Dieu-de-l-elec/IOX-77-Devboard/CAD-and-Renders/IOX_77_RENDER_01_CG_9.png

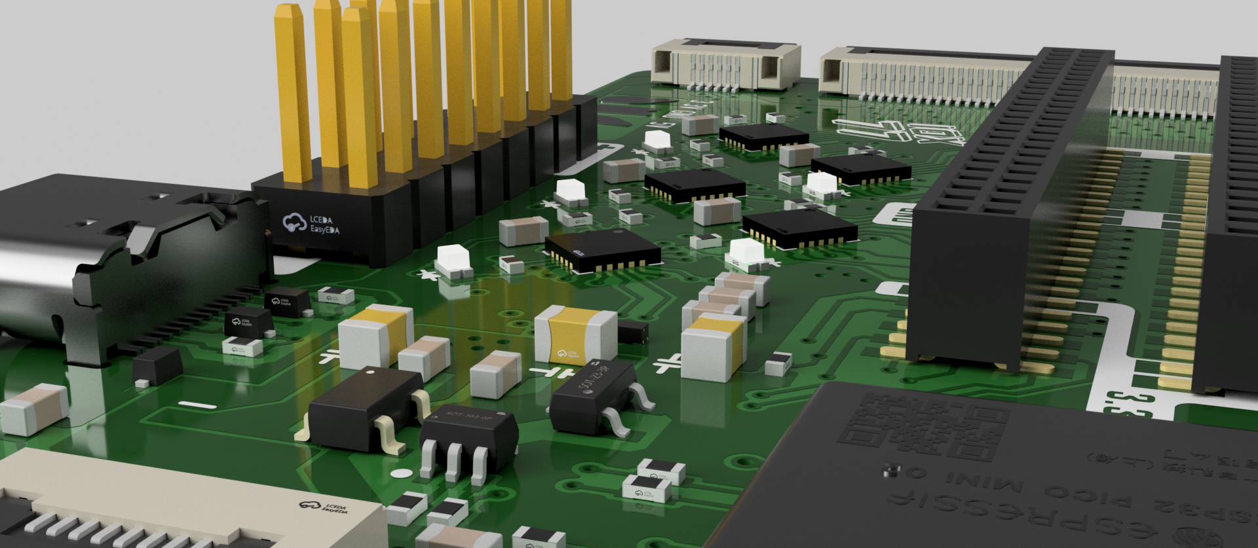
CAD-and-Renders/IOX_77_RENDER_01_CG_9.png
