Dieu-de-l-elec/IOX-77-Devboard/PINOUT/IOX_77_pinout.pdf

3.3V 3.3V 3.3V 3.3V 3.3V GND GND GND GND GND GND B.PD0 B.PC6 B.PC5 C.PC6 C.PC5 A.PC6 A.PC5 E.PC6 E.PC5 D.PC6 D.PC5 +5V +5V 3.3V 3.3V GND GND 3.3V A.PC7 A.PD0 C.PC7 3.3V D.PC7 E.PD0 C.PD0 SDA SCL TXRX B.PC7 E.PC7 ENBOOT GND

## 5V tolerant pins

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
9 | C.PC3
10 | B.PC4
11 | B.PC7
12 | B.PD2
13 | B.PD3
14 | B.PD4
15 | B.PD5
16 | B.PD6
17 | C.PA2
18 | C.PA1
19 | +3.3V
20 | +3.3V
21 | +3.3V
22 | +3.3V
23 | C.PC6
24 | C.PC5
25 | A.PD2
26 | A.PD3
27 | A.PD4
28 | A.PD5
29 | A.PD6
30 | A.PC7
31 | A.PC6
32 | A.PC5
33 | A.PC4
34 | A.PC3
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
# GND

TX
RX

# SCL SDA

+3.3V

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
# GND

# C.SWIO B.SWIO A.SWIO E.SWIO D.SWIO

+3.3V

IOX-77 PINOUT ⁵V T. 5V T.

10.04.2026

C. G.
#Dieu de l’élec | BOOT

# RST

# PRG

# IOs

# COM

# IOs

# COM

# PRG FPCs

Headers 2x25 1.27mm | 3.3V B.PA2 | A.PD5 A.PD6 | A.PA2 | C.PA2 | C.PD5 D.PD5 | D.PD6 | C.PD6 | E.PA2 B.PD6 | B.PD5 | E.PD6 | E.PD5 C.PC3 | B.PC0 | A.PC0 | A.PC3 | D.PD0 | D.PC0 | D.PC3 B.PA1 | A.PD4 | A.PD2 A.PD3 | A.PA1 | C.PD2 | E.PA1 | D.PC4 E.PC0 B.PC3 | E.PC3 D.PD2 | D.PD3 | D.PD4 | C.PA1 | C.PD3 | C.PC4 | D.PA1 B.PD4 | B.PD3 | B.PD2 | B.PC4 | E.PD4 | E.PD3 | E.PD2 | E.PC4 A.PC4 | C.PC0 | D.PA2 C.PD4

# GND GND B.PC5 P.PC6 B.PA1 B.PA2 B.PD0 B.PC0

# A.PC0 A.PD0 A.PA2 A.PA1 GND GND

PWM | ANALOG | IO.3 | IO.2 | IO.0

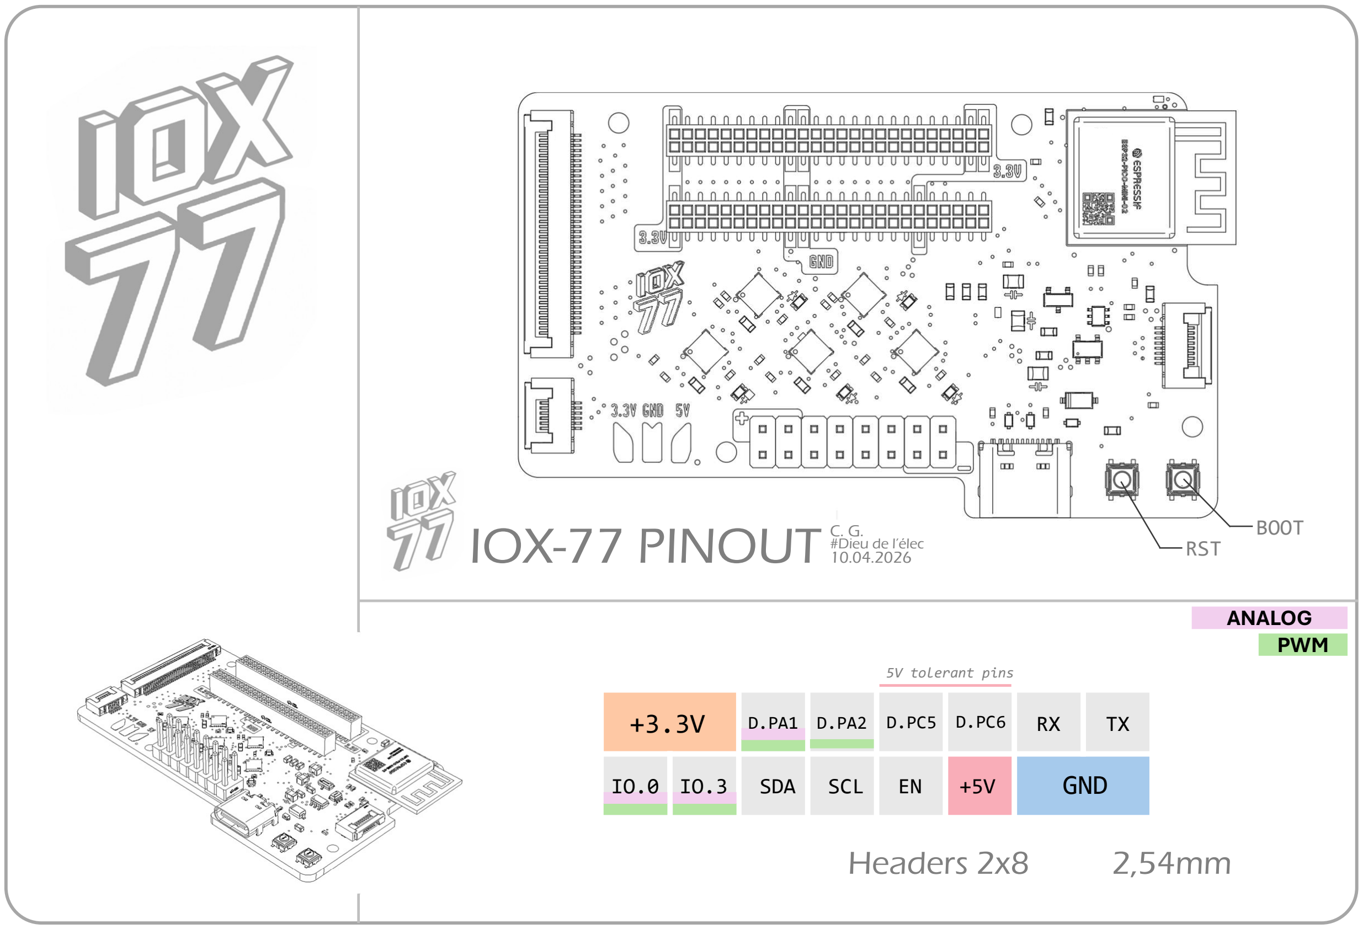
[picture p3: page 2]

+3.3V | D.PA1 | D.PA2 | D.PC5 | D.PC6 | RX | TX
IO.0 | IO.3 | SDA | SCL | EN | +5V | GND

## 5V tolerant pins

# IOX-77 PINOUT 10.04.2026

C. G.

## #Dieu de l’élec

# BOOT RST

# Headers 2x8 2,54mm

# PWM

# ANALOG

# PWR through Shield

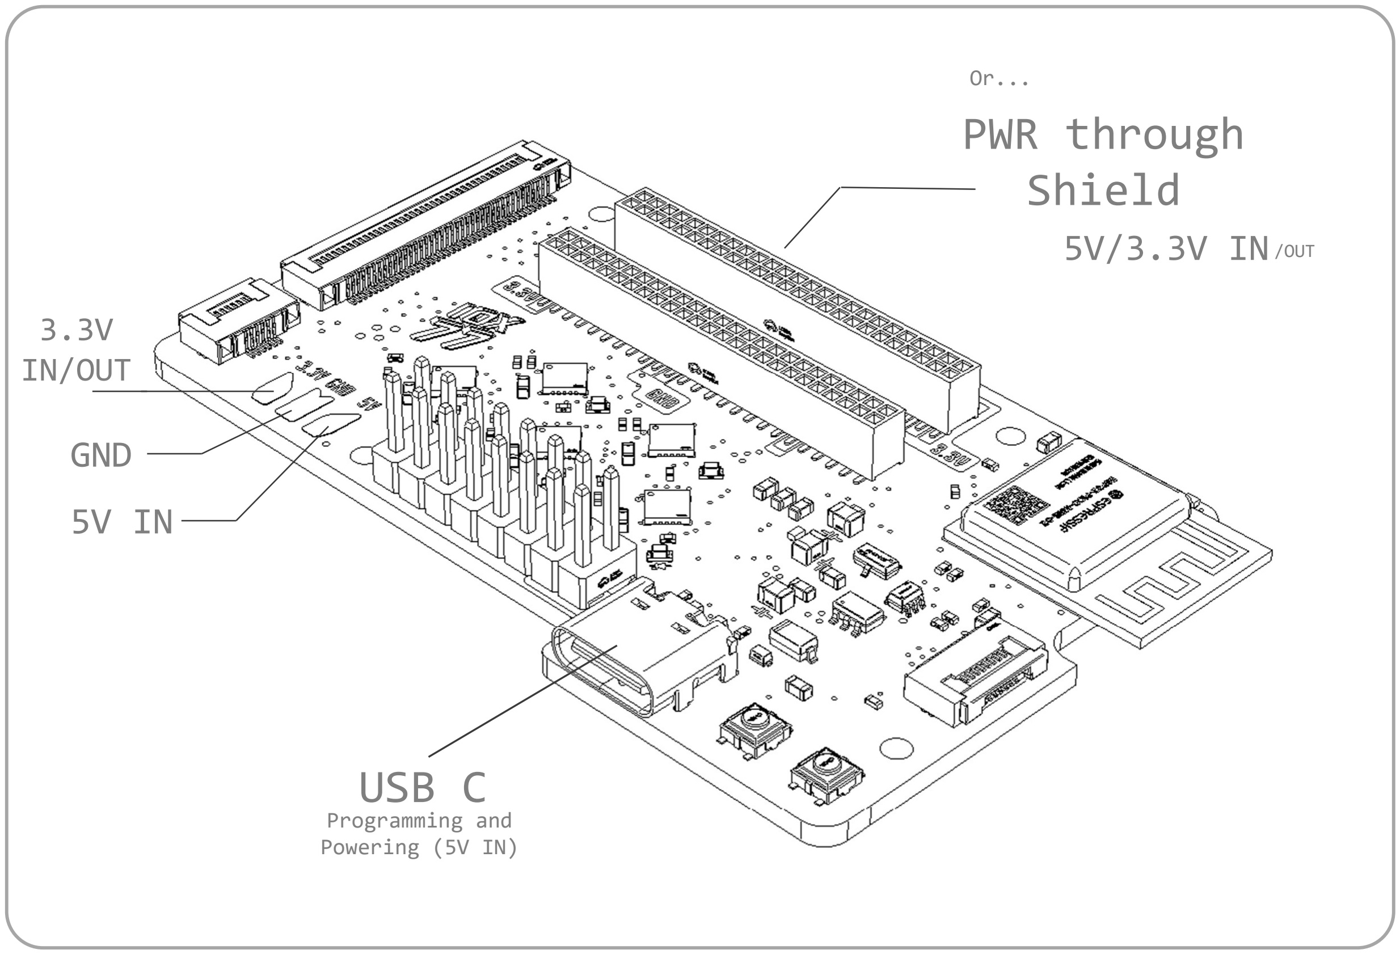
[picture p4: page 3]

# USB C

# Programming and Powering (5V IN)

# 5V IN

3.3V

# IN/OUT

# GND

Or...

# 5V/3.3V IN/OUT
