Dieu-de-l-elec/IOX-77-Devboard/assets/LCSC CART1.png

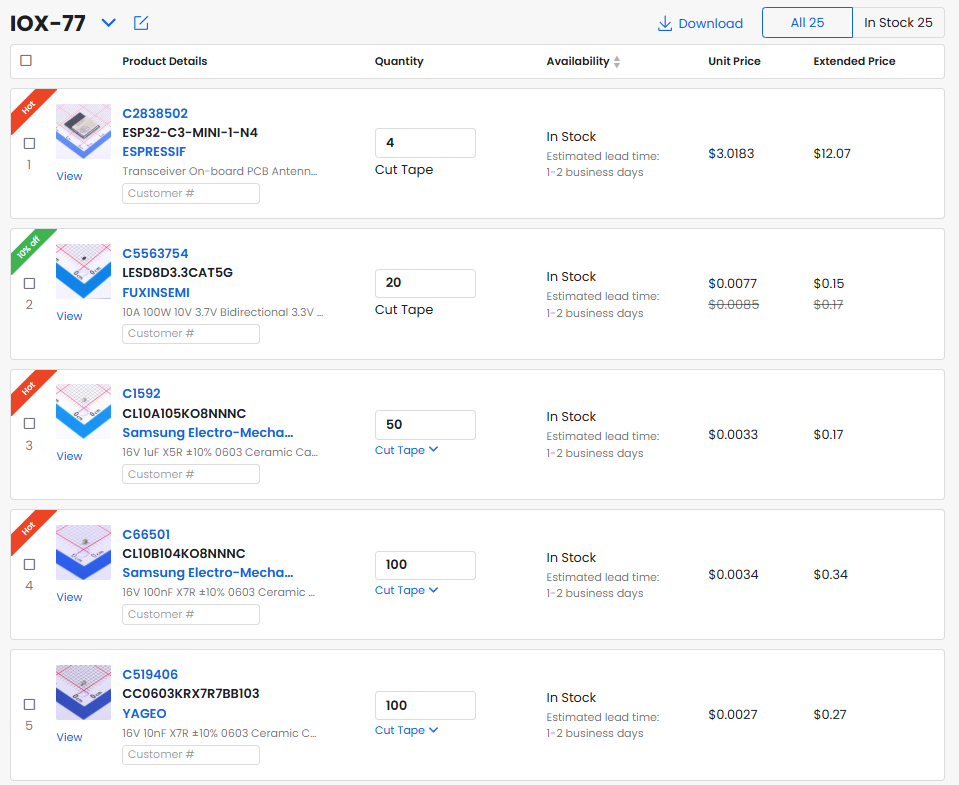
assets/LCSC CART1.png
