Dieu-de-l-elec/IOX-77-Devboard/assets/LCSC CART2.png

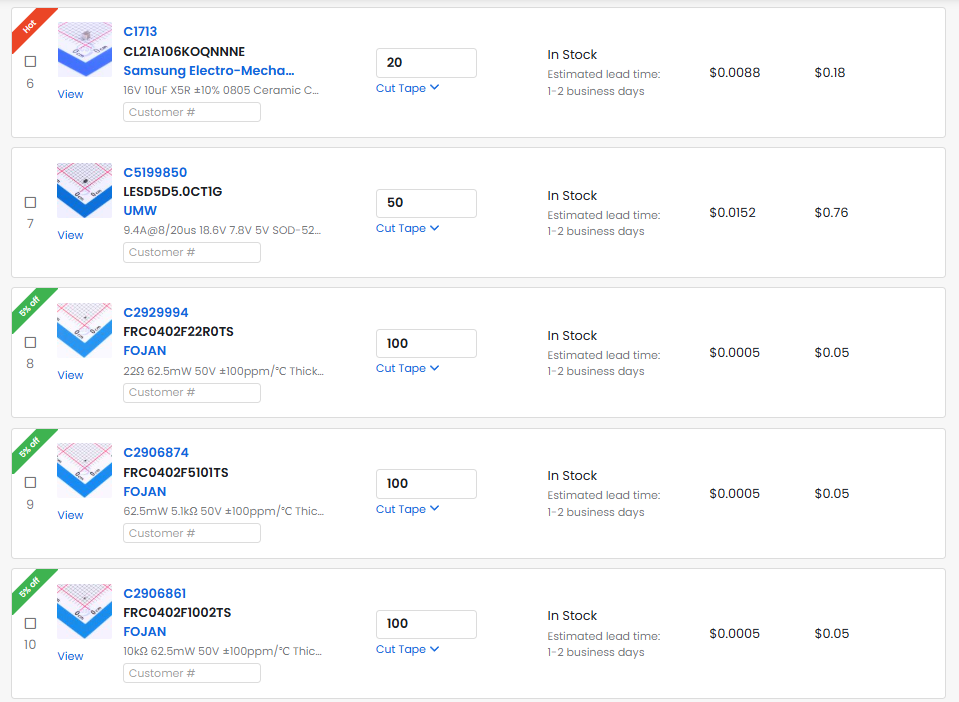
assets/LCSC CART2.png
