Dieu-de-l-elec/IOX-77-Devboard/assets/LCSC CART3.png

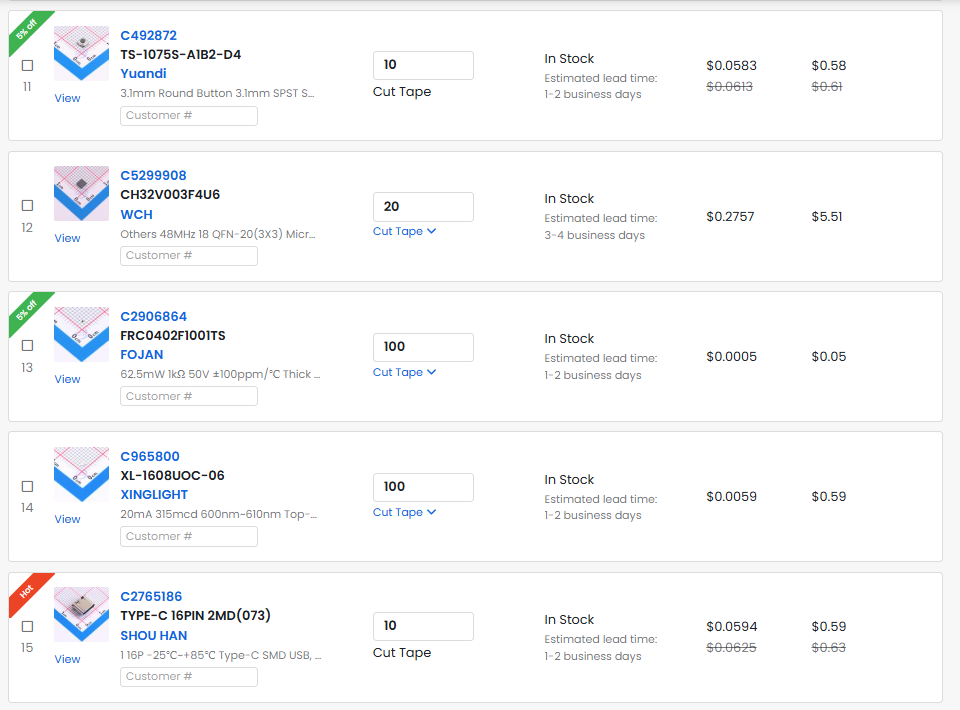
assets/LCSC CART3.png
