Dieu-de-l-elec/IOX-77-Devboard/assets/LCSC CART4.png

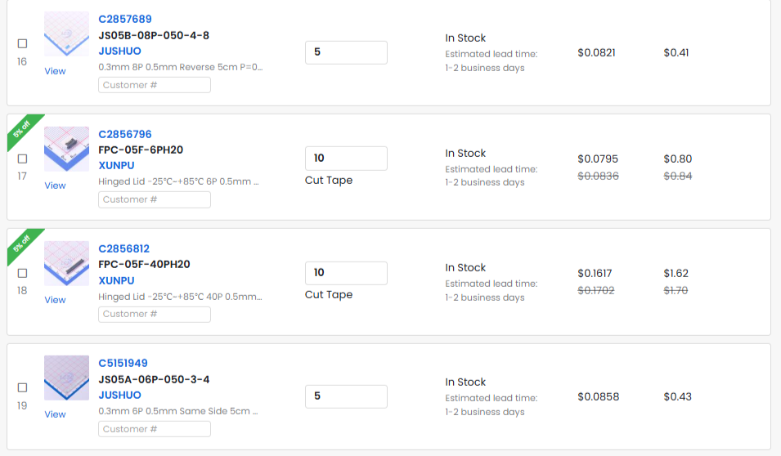
assets/LCSC CART4.png
