Dieu-de-l-elec/IOX-77-Devboard/assets/LCSC CART5.png

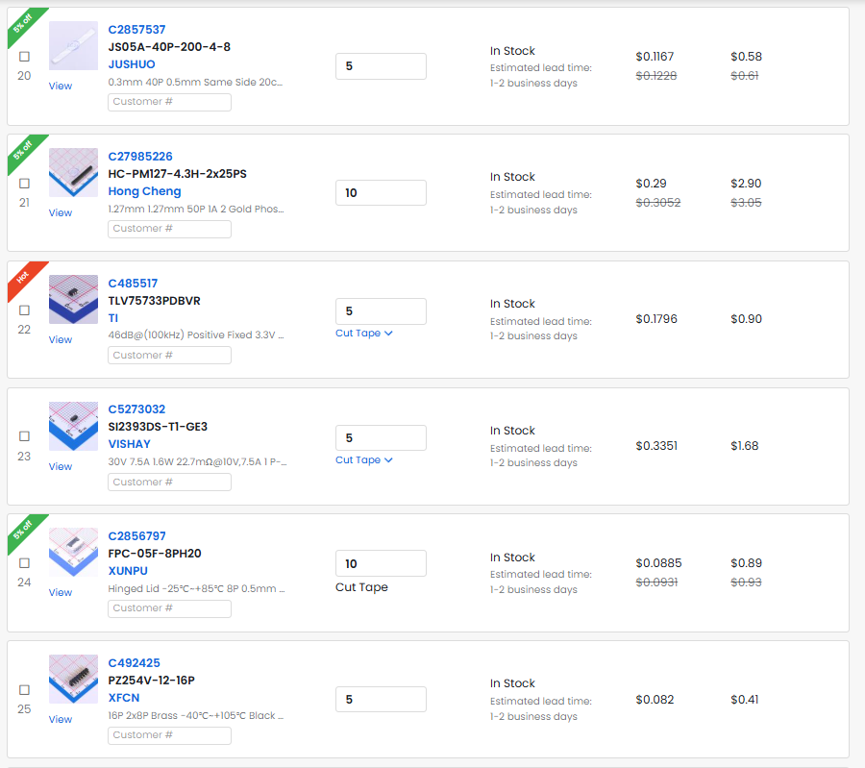
assets/LCSC CART5.png
