Dieu-de-l-elec/IOX-77-Devboard/assets/LCSC CART PRICE.png

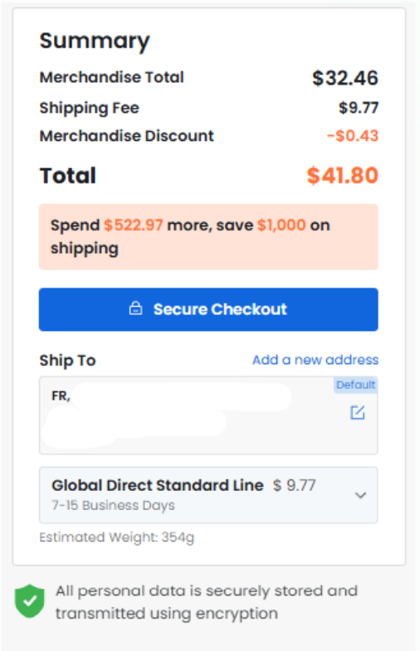
assets/LCSC CART PRICE.png
