Dieu-de-l-elec/IOX-77-Devboard/assets/PRICE SIMULATION.png

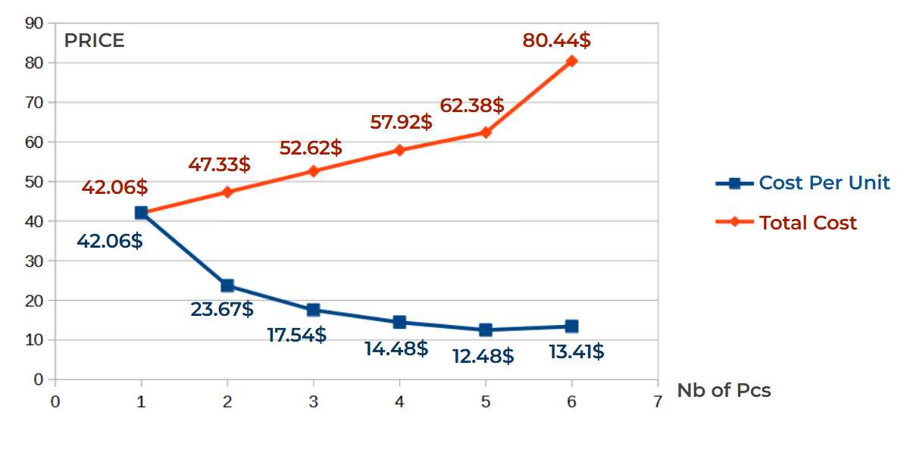
assets/PRICE SIMULATION.png
