Dieu-de-l-elec/IOX-77-Devboard/assets/WCH linkE ITEM.png

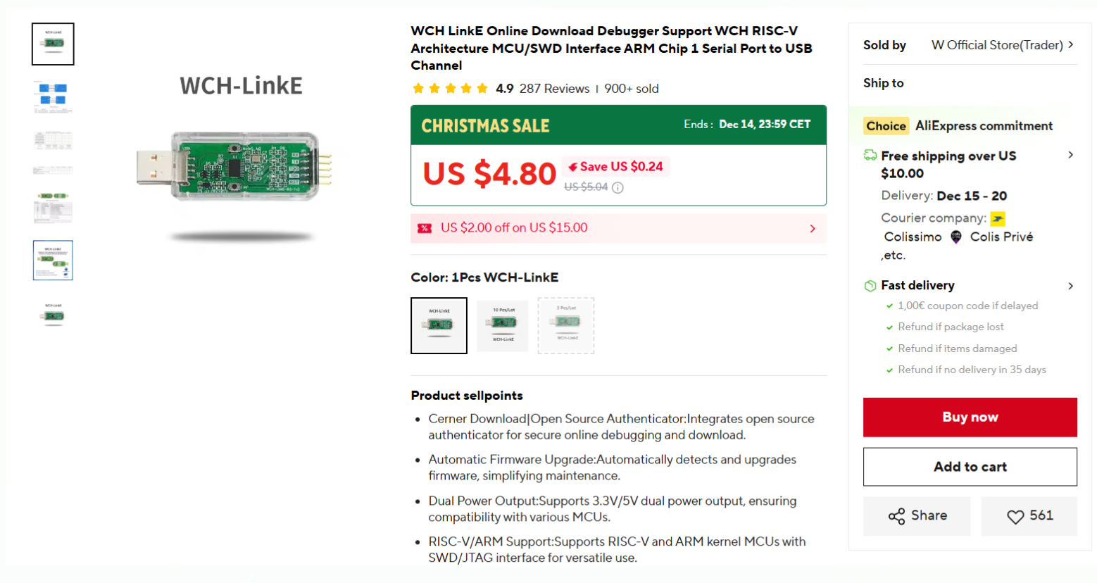
assets/WCH linkE ITEM.png
