Dieu-de-l-elec/IOX-77-Devboard/assets/WCH linkE.png

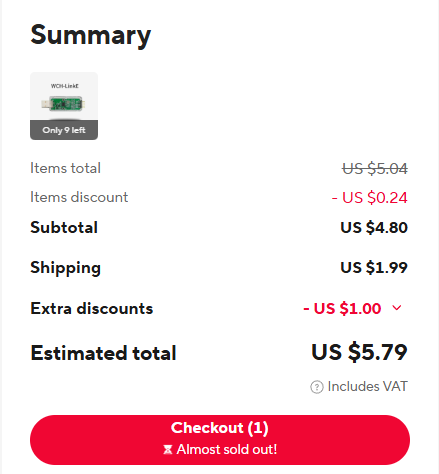
assets/WCH linkE.png
