Dieu-de-l-elec/IOX-77-Devboard/CAD-and-Renders/BOARD PCB 10 5.png

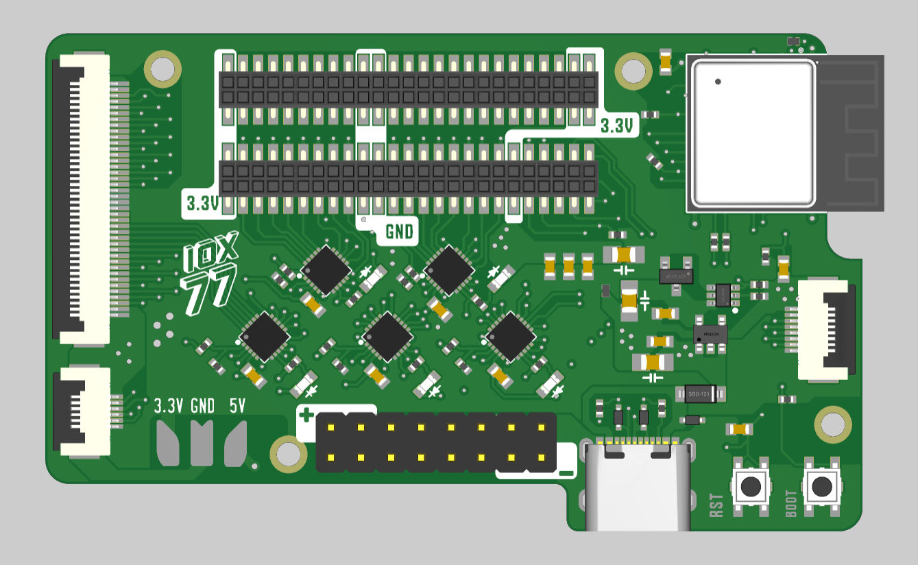
CAD-and-Renders/BOARD PCB 10 5.png
