Dieu-de-l-elec/IOX-77-Devboard/CAD-and-Renders/IOX_77_RENDER_CG_05.png

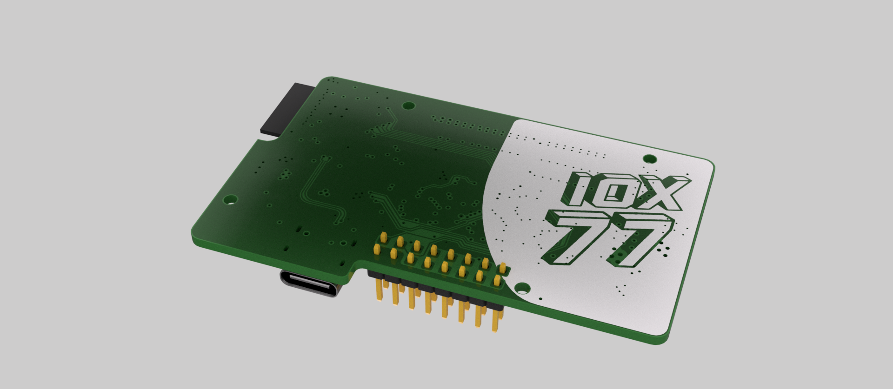
CAD-and-Renders/IOX_77_RENDER_CG_05.png
