Dieu-de-l-elec/IOX-77-Devboard/PCB/IOX77_RENDER_02_CG.png

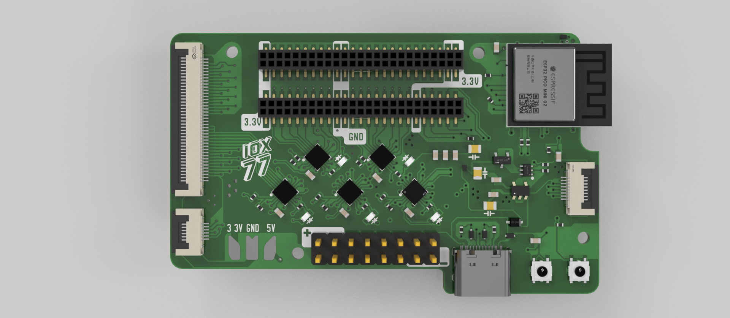
PCB/IOX77_RENDER_02_CG.png
