Dieu-de-l-elec/IOX-77-Devboard/PCB/IOX_77_RENDER_01_CG_08.png

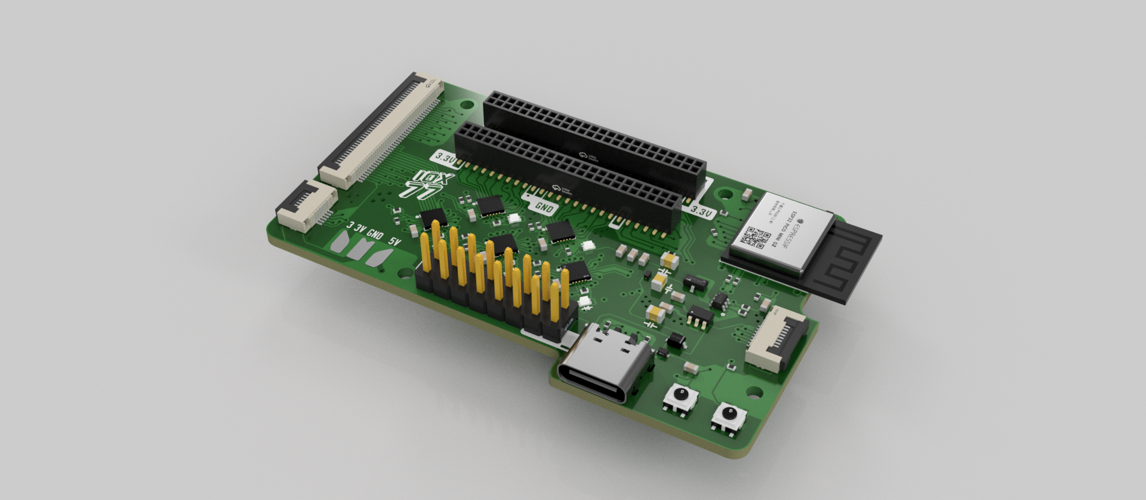
PCB/IOX_77_RENDER_01_CG_08.png
