Dieu-de-l-elec/IOX-77-Devboard/assets/JLCPCB ORDER SCREENSHOT.png

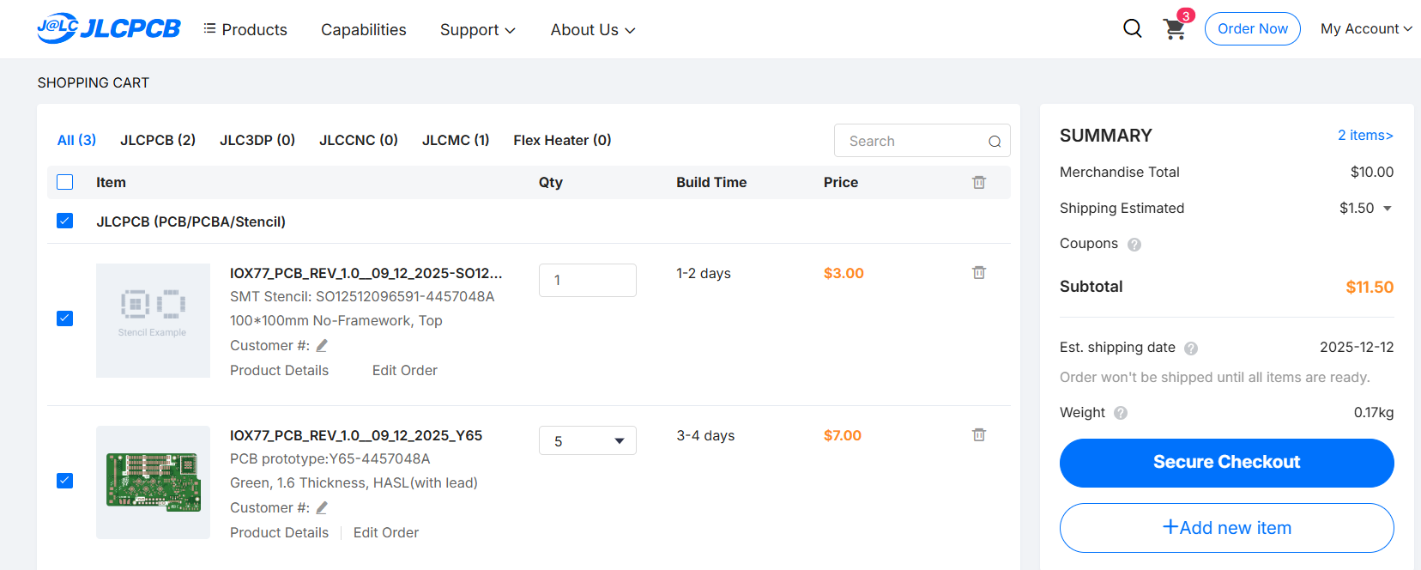
assets/JLCPCB ORDER SCREENSHOT.png
