Dieu-de-l-elec/IOX-77-Devboard/(list of files, drawings)

Other design files:
PCB/IOX_77_easyEDA_proj_2026-04-07.epro
